AizenDove/scentOSC/README.md

<div align="center">

scentOSC logo

# scentOSC

**Scent in VRChat.** Build KVX, a 73 g scent emitter that clips onto your VR headset, and trigger it from your avatar through OSC.










[Overview](#overview) ·
[Bill of materials](#bill-of-materials) ·
[Print](#3d-printed-parts) ·
[Wiring](#wiring) ·
[Assembly](#assembly-steps) ·
[Firmware](#flashing-firmware-and-connecting-to-vrchat) ·
[Troubleshooting](#testing-and-troubleshooting) ·
[License](#license)

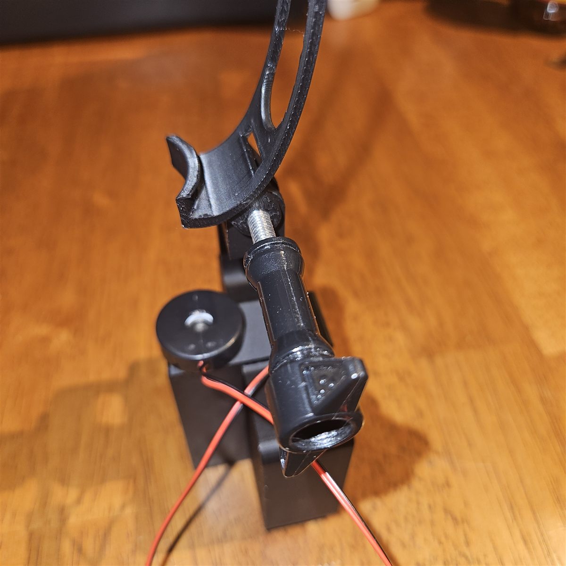
[picture p1: assets/photos/20261010_195304.jpg]
KVX mounted on a headset


</div>

> [!WARNING]
> **Work in progress:** KVX and this guide are still being developed. Parts, steps and files may change.

## Disclaimer

Build and use KVX at your own risk. I take no responsibility for injury, illness or damage.

- **Health:** breathing in scented mist may be unhealthy. If you feel unwell, take the headset off, and see a doctor if it doesn't pass.
- **Water and electronics:** the unit puts liquid next to live electronics. I take no responsibility for broken electrical components or water damage.
- **Not leak-proof:** don't lean too far forward or lie down while wearing it.
- **Run time:** the reservoir holds about 7 ml, roughly 2–3 minutes of continuous mist.
- **Spares:** keep spare transducers, as the piezo discs break easily. The wick is a consumable: replace it every time you refill. Spare 20 mm piezo discs and 10 mm wicks are sold cheaply in USB mist maker kits; see [3D printed parts](#3d-printed-parts).

## Overview

KVX is a 73 g scent emitter that mounts on your VR headset: a WEMOS LOLIN S3 drives one Grove ultrasonic atomizer, and VRChat triggers it through [ToolKitOSC](https://github.com/NekoTiki/ToolKitOSC).

```mermaid
flowchart LR
    VRC["VRChat"] -- "OSC" --> TK["ToolKitOSC<br/>desktop app"]
    TK -- "WebSocket over Wi-Fi" --> MCU["ESP32-S3"]
    MCU -- "GPIO" --> ATM["Atomizer"]
```

| | |
| --- | --- |
| **Weight** | 73 g |
| **Capsules** | 1 |
| **Power** | 5 V over USB-C, from the headset |
| **Parts** | All printable on a desktop 3D printer |
| **Headset mounts** | Meta Quest 3, Pico 4, Steam Frame, or any headset with a GoPro-style mount |

## Repository layout

```text
scentOSC/
├── README.md              this guide
├── LICENSE                CERN-OHL-S v2
├── assets/
│   ├── logo.svg
│   └── photos/            assembly photos
└── print-files/
    ├── Box.stl            electronics box with arm
    ├── Cap.stl            lid
    ├── Container-13.5mm.stl  reservoir tower with a 13.5 mm hole for the atomizer holder
    ├── step-files/        STEP versions of the KVX parts, for editing
    └── mounts/            third-party headset mounts
        ├── quest-3/
        ├── pico-4/
        └── steam-frame/
```

## Bill of materials

One KVX needs one ESP32 board, one atomizer kit and a USB-C cable to your headset. The atomizer draws at most 2 W, about 0.4 A at 5 V, so the headset's USB-C port can power the whole unit.

| Part | Qty | Key specs | Price (USD) | Where |
| --- | --- | --- | --- | --- |
| [WEMOS LOLIN S3](https://www.wemos.cc/en/latest/s3/s3.html) | 1 | ESP32-S3-WROOM-1, 3.3 V logic, 16 MB flash, 8 MB PSRAM, 65.3 × 25.4 mm, 9 g | about 7 | [AliExpress (official WEMOS store)](https://www.aliexpress.com/item/1005004643475363.html) |
| [Grove – Water Atomization v1.0](https://wiki.seeedstudio.com/Grove-Water_Atomization/) (SKU 101020090) | 1 | 5 V DC, 2 W max, 105 kHz; kit = driver board, Grove cable, ultrasonic transducer | 10.90 | [Seeed Studio](https://www.seeedstudio.com/Grove-Water-Atomization-v1-0.html) |
| Atomizer holder | 1 | 3D printed holder that clamps the 20 mm transducer and holds the 10 mm wick; use with `Container-13.5mm.stl` | — | [Thingiverse](https://www.thingiverse.com/thing:6420549) (print it yourself) |
| Jumper wires | 3 | Driver J1 pins (EN, VCC, GND) to the LOLIN S3 | — | Any electronics shop |
| USB-C cable | 1 | Headset USB-C port to the LOLIN S3; carries 5 V | — | Any |
| Wick | 1, plus plenty of spares | 10 mm cotton wick that fits the holder's tube; replace it at every refill | — | [AliExpress](https://www.aliexpress.com/item/1005005952918244.html) |
| Spare 20 mm piezo discs | Optional | Same 20 mm atomizer disc as in the Grove kit; works with the Grove driver board | — | [AliExpress](https://www.aliexpress.com/item/1005004559429683.html) |
| Scent liquid | Any | Any water-based liquid that gives off a scent; you choose what to smell. Dilute it with distilled water if it is too strong or too thick. | — | Any |
| Printed parts | 1 set | Box with arm, lid, reservoir tower, headset mount; see next section | — | Your printer |

Prices were checked on 12 Oct 2026. The LOLIN S3 price is from its launch and may have changed.

> [!NOTE]
> **Links and prices change.** The shops above are only recommendations. Look for the cheapest and most available option where you live.

## 3D printed parts

Print the three KVX parts, the atomizer holder and the mount for your headset. All files are in [`print-files/`](print-files).

| File | What it is | Supports |
| --- | --- | --- |
| [Box.stl](print-files/Box.stl) | Electronics box with the mounting arm | None |
| [Cap.stl](print-files/Cap.stl) | Lid for the box | None |
| [Container-13.5mm.stl](print-files/Container-13.5mm.stl) | Reservoir tower with a 13.5 mm hole for the atomizer holder | None |

**Atomizer holder:** print it from [4.15 Adapter for Mist Maker Kits](https://www.thingiverse.com/thing:6420549) by diy_mushroom_tek on Thingiverse (CC BY-NC-SA). Follow that page for the holder case, spare 10 mm wicks and spare 20 mm atomizers; those parts are compatible with this reservoir.

The Grove kit uses the same 20 mm piezo disc as those mist maker kits, so you still only need the Grove driver board: the wiring stays the same.

> [!WARNING]
> **Hole size must match:** the reservoir's hole diameter corresponds to the atomizer holder and wick diameter. If your holder or wick is a different size, edit the hole in the STEP file or follow the holder's guide for the best fit. Too loose and it leaks or tips; too tight and the wick gets squeezed and soaks poorly.

To modify the KVX parts in CAD, use the STEP versions in [`print-files/step-files/`](print-files/step-files).

> [!TIP]
> **Print settings:** 0.2 mm layers, 3 wall loops, 10% infill. Lay each KVX part with its largest flat face on the build plate.

**Headset mounts** are third-party designs, not made by me, and may need supports. Only the Quest 3 mount has been tested with KVX; the Pico 4 and Steam Frame mounts are untested. Any headset with a GoPro-style mount is compatible.

| Headset | File | Designer | Tested with KVX |
| --- | --- | --- | --- |
| Meta Quest 3 | [Q3_Mount.stl](print-files/mounts/quest-3/Q3_Mount.stl) | [GUUUL on Thingiverse](https://www.thingiverse.com/thing:7261225), CC BY-SA | ✅ Yes |
| Steam Frame | [sfmountv2.stl](print-files/mounts/steam-frame/sfmountv2.stl) | Third party, [Printables](https://www.printables.com/model/1868935-steam-frame-mount-for-vive-tracker-face-tracker) | ❌ No |
| Pico 4 | [HMD_Mount.stl](print-files/mounts/pico-4/HMD_Mount.stl) | Third party, [Printables](https://www.printables.com/model/495514-pico-4-babble-mouth-tracker-mount) | ❌ No |

## Tools needed

- 3D printer
- Soldering iron
- Double-sided tape, to hold the boards in the box
- USB-C data cable, for flashing the LOLIN S3
- PC with [PlatformIO](https://platformio.org/) and the ToolKitOSC desktop app
- 2.4 GHz Wi-Fi network
- Scissors, for cutting the cotton wicks
- Pipette or syringe, for filling the capsules

## Wiring

The headset powers the LOLIN S3 over USB-C, and the LOLIN S3 feeds the atomizer: EN to GPIO 4, VCC to the 5V pin, GND to GND.

```mermaid
flowchart LR
    HMD["VR headset<br/>USB-C port"] -. "5 V" .-> MCU["WEMOS LOLIN S3<br/>ESP32-S3, 3.3 V logic"]
    MCU -- "GPIO 4 → EN" --> DRV["Grove atomizer driver<br/>+ ultrasonic transducer"]
    MCU -. "5V pin → VCC" .-> DRV
    MCU -. "GND → GND" .-> DRV
```

| Driver pin (J1) | Wire in the photos | Connects to |
| --- | --- | --- |
| EN (the signal) | 🟤 Brown | GPIO 4 on the LOLIN S3 |
| VCC | 🔴 Red | 5V pin on the LOLIN S3 |
| GND | ⚫ Black | GND on the LOLIN S3 |
| NC | — | Nothing |

Plug the headset's USB-C cable into either port on the LOLIN S3; its 5V pin then carries USB power straight through to the atomizer. One atomizer draws at most 0.4 A, well within a headset's USB-C output. Any pin the firmware offers works; GPIO 4 is a suggestion.

> [!NOTE]
> Connect the driver's VCC straight to the 5V pin on the ESP32 board.

## Assembly steps

1. Lay out the parts: the electronics box with its arm, the lid, the reservoir tower, the headset mount and thumbscrew, the LOLIN S3, the Grove driver, the transducer, the atomizer holder and a wick.

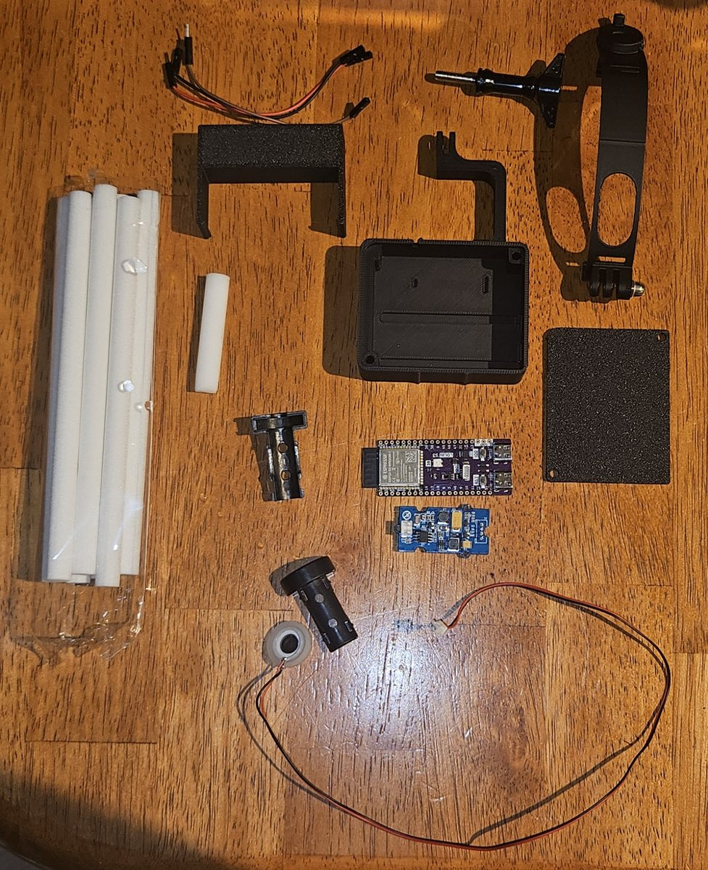
[picture p2: assets/photos/20261010_194210.jpg]
All KVX parts laid out
   

2. Seat the Grove driver in the upper bay of the box and the LOLIN S3 below it, with both USB-C ports facing the cutout in the side wall. Stick both boards down with double-sided tape so they don't shift; the next version will hold them in place.

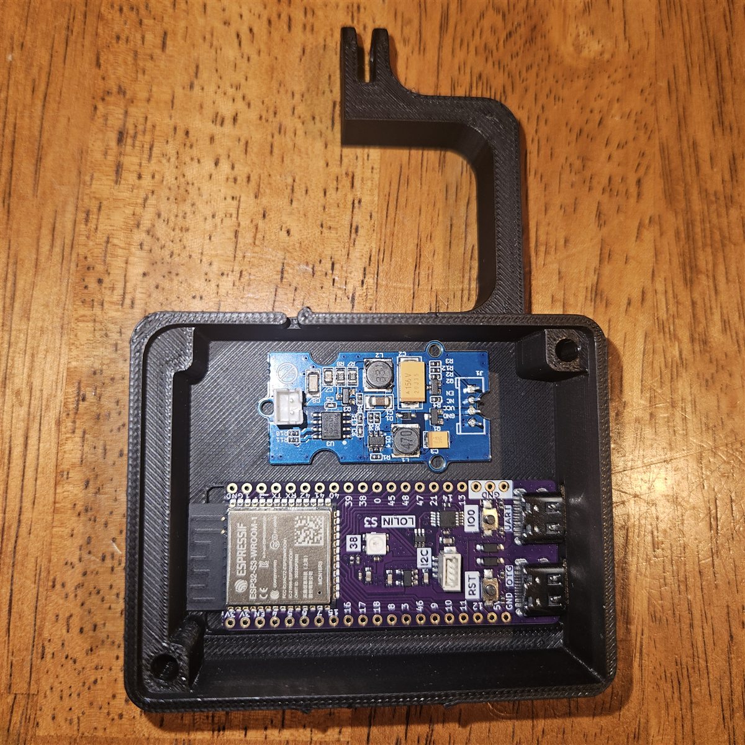
[picture p3: assets/photos/20261010_194624.jpg]
Driver and LOLIN S3 seated in the box
   

3. Run three jumper wires from the driver's J1 pins to the LOLIN S3: EN (brown) to GPIO 4, VCC (red) to 5V, GND (black) to GND.

   > [!CAUTION]
   > Never touch the transducer pins while powered: they reach 65 V. Inductor L2 on the driver board gets hot, so leave air around it.

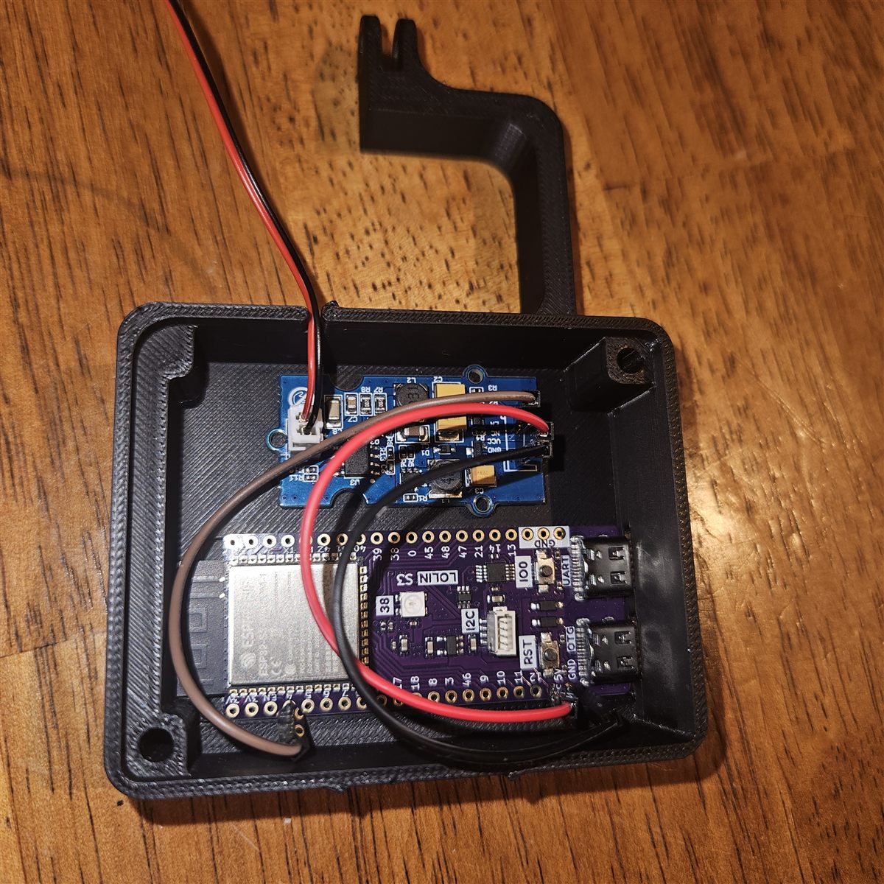
[picture p4: assets/photos/20261010_194839.jpg]
Jumper wires from the driver to GPIO 4, 5V and GND
   

4. Plug the transducer into the driver's white 2-pin socket and lead its cable out through the notch in the box wall.
5. Close the lid and fasten its two screws (optional).

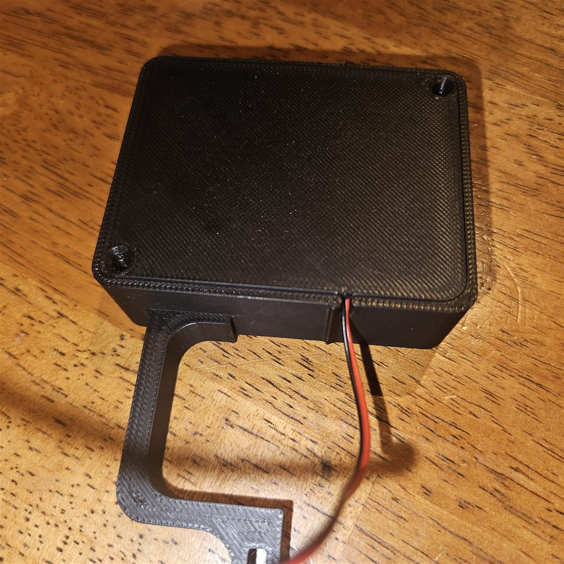
[picture p5: assets/photos/20261010_194922.jpg]
Closed box with the transducer cable leaving through the notch
   

6. Cut a fresh wick to 60 mm and push it into the atomizer holder's tube.

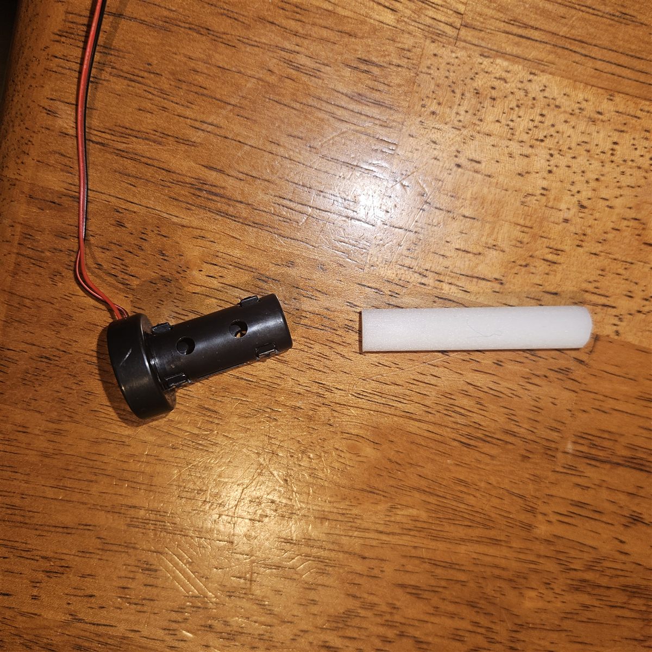
[picture p6: assets/photos/20261010_195049.jpg]
Atomizer holder and wick
   

7. Seat the transducer in the printed holder, mist side facing out.
8. Fill the reservoir tower (about 7 ml) with your water-based scent mix, then lower the holder in carefully and let the wick absorb the liquid.
   - A mix that is too thick clogs the wick and weakens the mist; dilute it with distilled water.
   - A wick that is not fully soaked gives only short bursts.

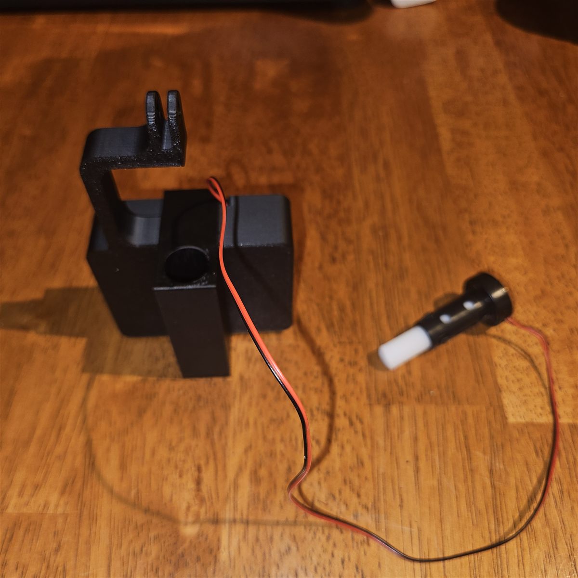
[picture p7: assets/photos/20261010_195142.jpg]
Holder ready to drop into the reservoir tower
   
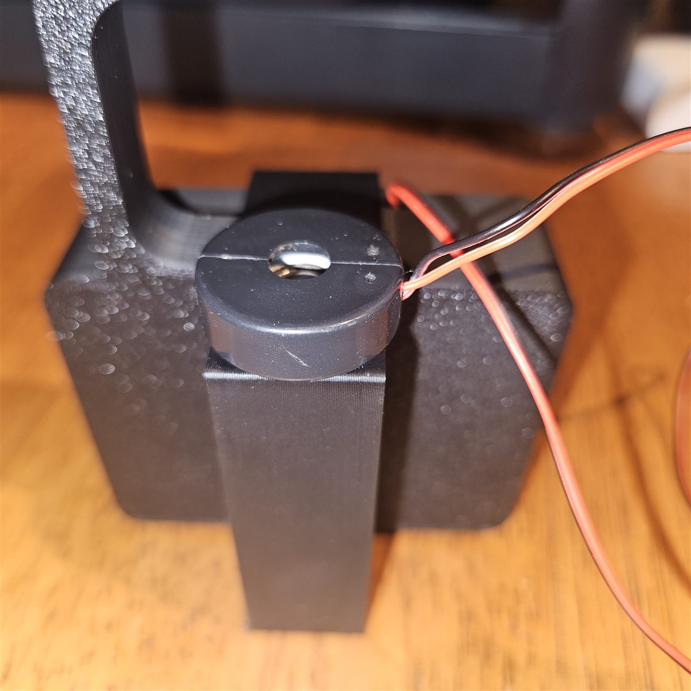
[picture p8: assets/photos/20261010_195219.jpg]
Holder seated in the tower
   

9. Attach the unit to the headset mount with the thumbscrew, plug the USB-C cable into the headset, and angle the cap so the mist lands just below your nose, not into it.

   Unit on the headset mount

## Flashing firmware and connecting to VRChat

Flash [ToolKitOSC-ESP32](https://github.com/NekoTiki/ToolKitOSC-ESP32) with the `lolin_s3` environment, then pair the board in the ToolKitOSC app.

1. Plug the LOLIN S3 into your PC through the port marked **USB**.
2. Clone the firmware and flash it:

   ```bash
   git clone https://github.com/NekoTiki/ToolKitOSC-ESP32.git
   cd ToolKitOSC-ESP32
   pio run -e lolin_s3 -t upload
   pio device monitor
   ```

3. If the upload does not connect, hold **BOOT**, tap **RST**, release BOOT and try again.
4. On first boot the board opens a Wi-Fi network called `ToolKitOSC-Setup-<id>`. Join it from your phone, pick your 2.4 GHz network, name the board, and choose the **WEMOS LOLIN S3** profile.
5. In ToolKitOSC, open **Settings › ESP32 boards**, click **Add** next to the board, then press its **BOOT** button within 30 seconds. The status LED turns green when connected.
6. Add one output on GPIO 4. Leave **active low** off: the Grove driver atomizes when its signal is HIGH.
7. Map the output to an avatar parameter. Use a pulse for short bursts (a gunshot) or PWM for intensity (a bowstring drawn further).
8. Keep **max on-time** at its 10 s default or lower, so a stuck parameter cannot run a capsule dry.

> [!IMPORTANT]
> The board switches the atomizer off if ToolKitOSC goes quiet for 3 s or Wi-Fi drops. The `TKOSC/Panic` avatar parameter stops everything at once.

## Testing and troubleshooting

Test the atomizer from the ToolKitOSC app before wearing the unit. The serial monitor shows each command as `[cmd]` and each real pin change as `[out]`.

| Symptom | Likely cause | Fix |
| --- | --- | --- |
| No mist, `[out]` shows the pin on | Wick dry or liquid too low | Refill until the wick is fully soaked |
| No mist, no `[out]` line | Output not mapped, or tripped by max on-time | Check the mapping; send off or Stop to clear the trip |
| Mist starts strong, then fades | Mix too thick, clogging the wick | Replace the wick; dilute the mix with distilled water |
| Transducer stops when wet on top | Transducer sits below the waterline | Raise it so only the hollow underside touches the wick |
| Board missing in ToolKitOSC | mDNS blocked (VPN, guest network) | Use **Add by address** with the IP from the serial monitor |
| Status LED blinks yellow | Board is not on Wi-Fi | Check that the network is 2.4 GHz; after 3 min the setup network reopens |
| Scent feels too strong | Capsule too close to the nose | Angle it lower; aim just below the nose, not into it |

To unpair, hold BOOT for 3 s while the board runs. To factory reset, hold it for 10 s.

## Sources

- Widerberg, Hong, de Petris, Fiedler, Khatibi: [Immersive Enhancement of Game Experience by Smell Sensing](https://doi.org/10.1007/978-3-032-11043-5_27), GALA 2025, LNCS 16307, pp. 280–289
- [ToolKitOSC](https://github.com/NekoTiki/ToolKitOSC), desktop app and VRChat OSC bridge
- [ToolKitOSC-ESP32](https://github.com/NekoTiki/ToolKitOSC-ESP32), board firmware
- [Grove – Water Atomization wiki](https://wiki.seeedstudio.com/Grove-Water_Atomization/), Seeed Studio
- [LOLIN S3 documentation](https://www.wemos.cc/en/latest/s3/s3.html), WEMOS
- [Quest 3 facial tracker mount](https://www.thingiverse.com/thing:7261225) by GUUUL, Thingiverse

## License

Copyright Chelsea Hong 2026.

KVX is open hardware, licensed under the [CERN Open Hardware Licence Version 2 – Strongly Reciprocal](LICENSE) (CERN-OHL-S v2). This covers the KVX print files (`Box.stl`, `Cap.stl`, `Container-13.5mm.stl`) and their STEP versions, this guide, the logo and the photos in `assets/`.

You may use, modify and share the design, and build and sell products from it. If you share a modified version, or products made from one, you must also share your modified source under the same licence.

Source location: https://github.com/AizenDove/scentOSC. As the licence requires, products made from this source must point to this location.

This source is distributed WITHOUT ANY EXPRESS OR IMPLIED WARRANTY, INCLUDING OF MERCHANTABILITY, SATISFACTORY QUALITY AND FITNESS FOR A PARTICULAR PURPOSE. Please see the CERN-OHL-S v2 for applicable conditions.

**Third-party files are not covered.** The printed atomizer holder on Thingiverse keeps its designer's CC BY-NC-SA licence. The headset mounts in [`print-files/mounts/`](print-files/mounts) keep their designers' licenses; the Quest 3 mount by GUUUL is CC BY-SA.

<div align="center">
<sub>Guide by <a href="https://github.com/AizenDove">@AizenDove</a> · last updated 23 Oct 2026</sub>
</div>
