AizenDove/scentOSC/downloads/HMD Mounts/Steam Frame/README.txt

Third-party design, not made by me. Untested with KVX.
Source: https://www.printables.com/model/1868935-steam-frame-mount-for-vive-tracker-face-tracker
