AizenDove/scentOSC/photos/originals/20261010_194210.jpg

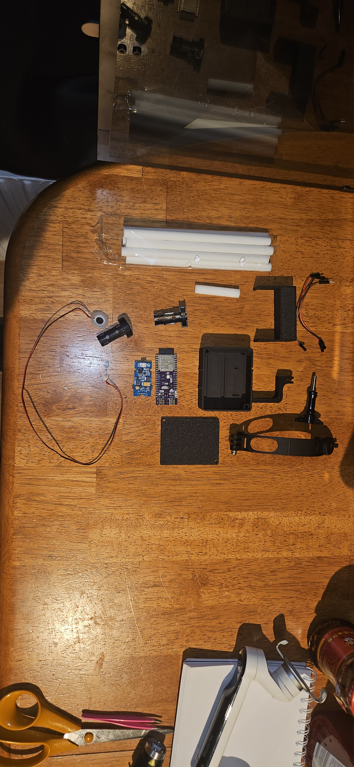
photos/originals/20261010_194210.jpg
