AizenDove/scentOSC/photos/originals/20261010_194446.jpg

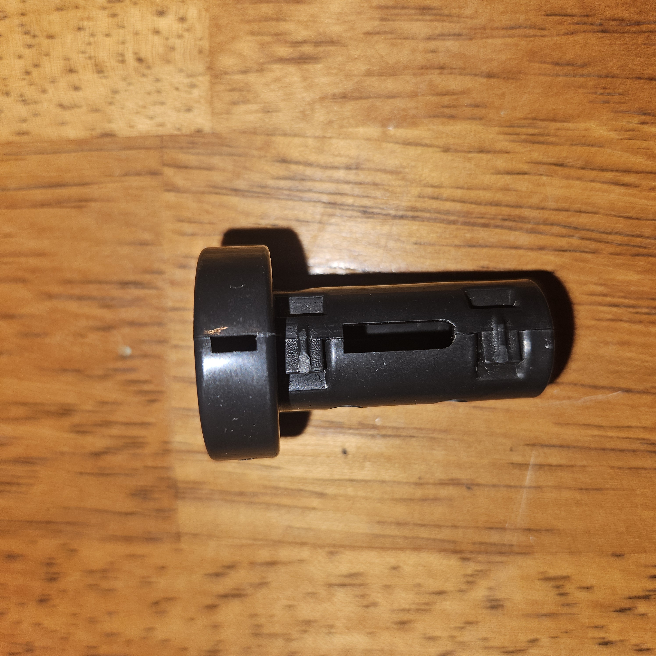
photos/originals/20261010_194446.jpg
