AizenDove/scentOSC/photos/originals/20261010_194817.jpg

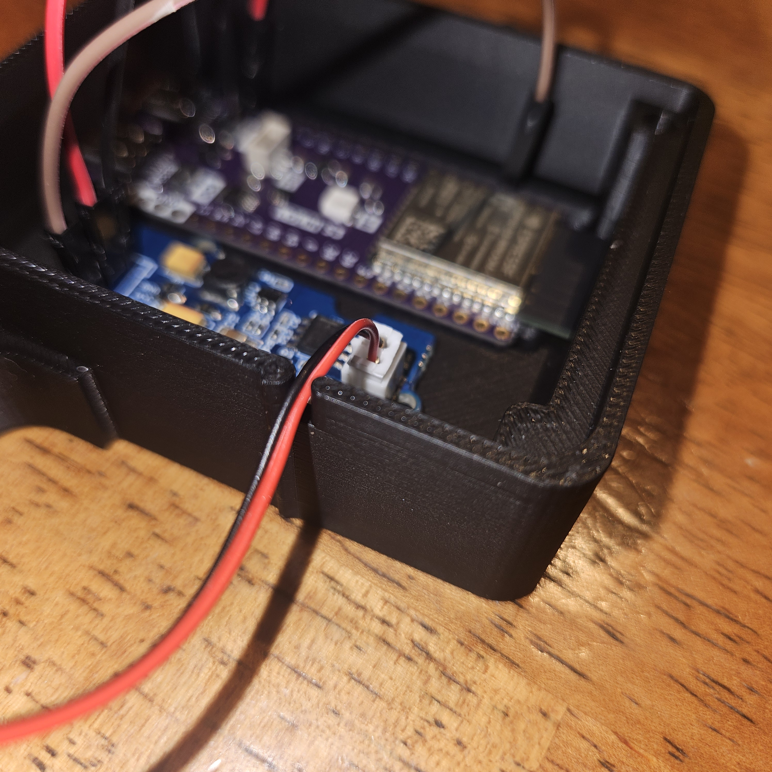
photos/originals/20261010_194817.jpg
