AizenDove/scentOSC/photos/originals/20261010_194934.jpg

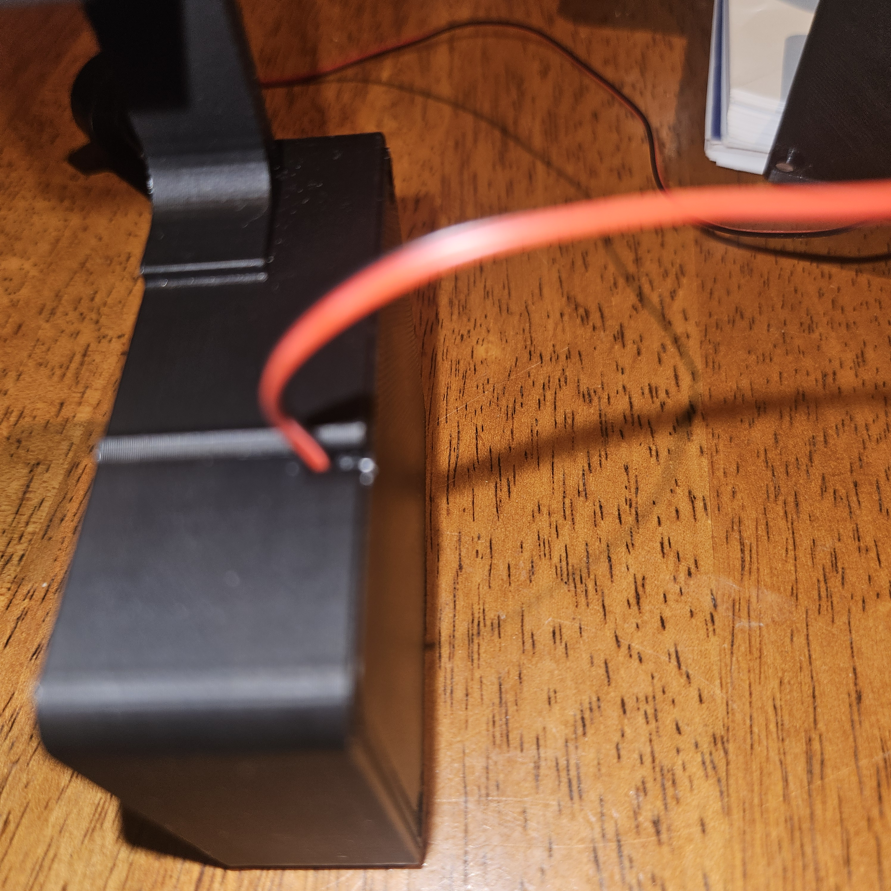
photos/originals/20261010_194934.jpg
