AizenDove/scentOSC/photos/originals/20261010_194937.jpg

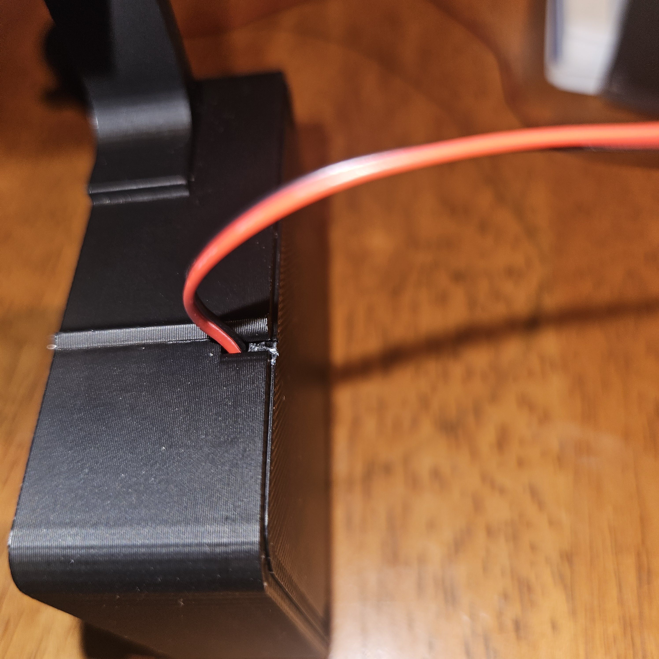
photos/originals/20261010_194937.jpg
