AizenDove/scentOSC/photos/originals/20261010_194957.jpg

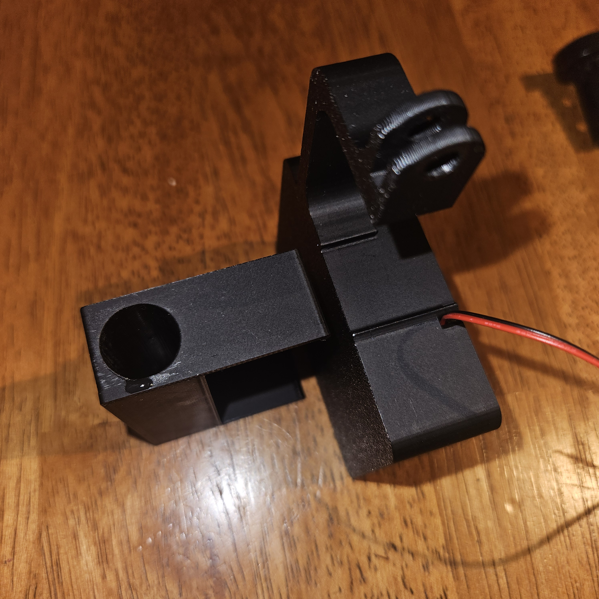
photos/originals/20261010_194957.jpg
