AizenDove/scentOSC/photos/originals/20261010_195202.jpg

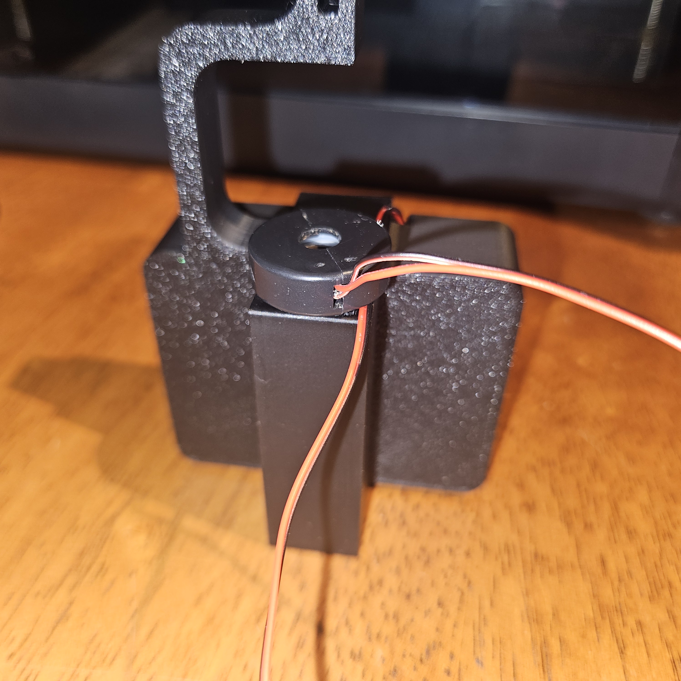
photos/originals/20261010_195202.jpg
