AizenDove/scentOSC/print-files/Cap.stl

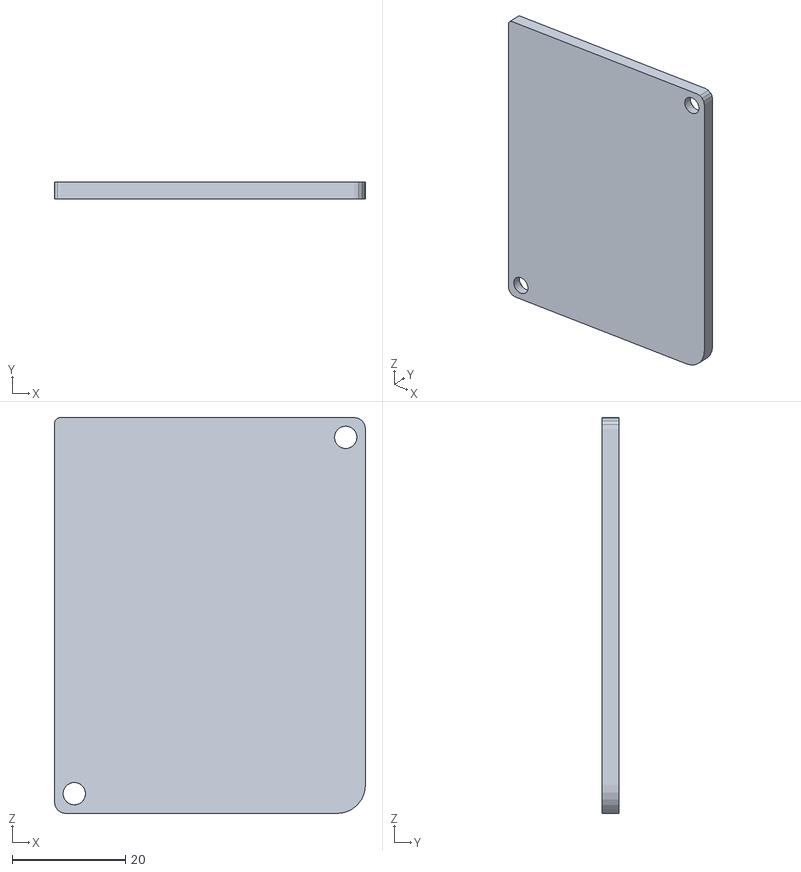
[picture p22: CAD file, 2026-10-12]
print-files/Cap.stl
54.9 x 3.00 x 69.9
