AizenDove/scentOSC/print-files/mounts/pico-4/HMD_Mount.stl

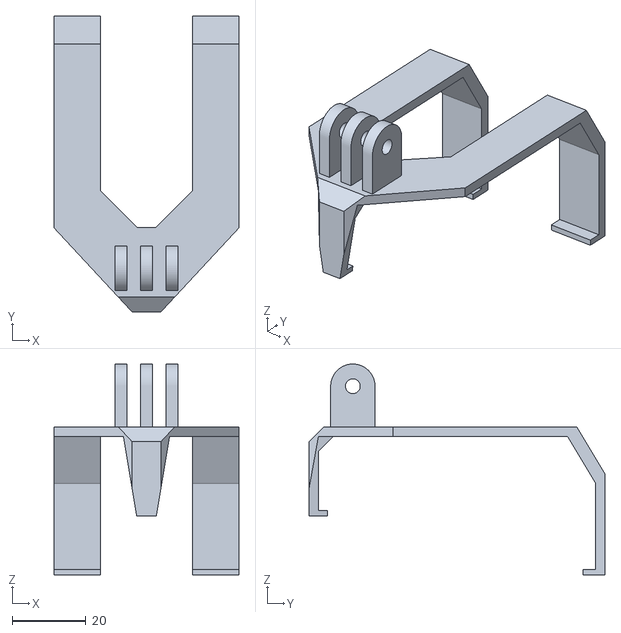
[picture p23: CAD file, 2026-10-12]
print-files/mounts/pico-4/HMD_Mount.stl
50.0 x 80.0 x 57.0
