AizenDove/scentOSC/print-files/mounts/quest-3/Q3_Mount.stl

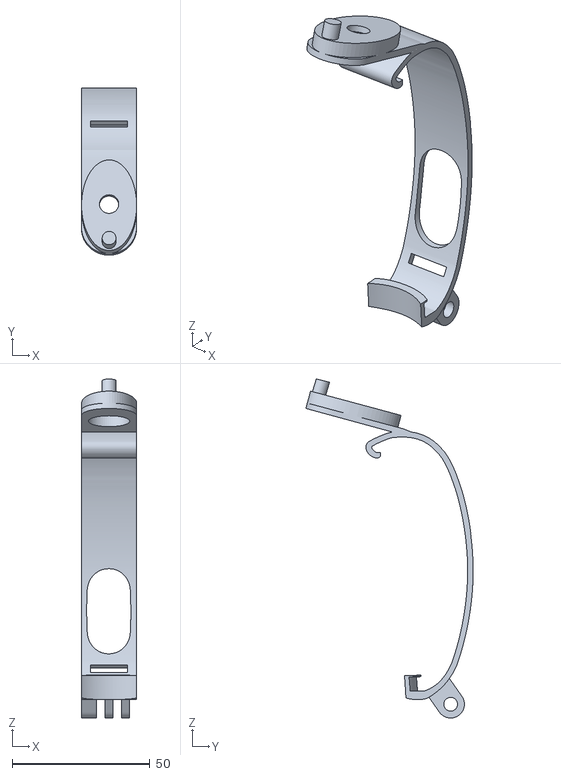
[picture p24: CAD file, 2026-10-12]
print-files/mounts/quest-3/Q3_Mount.stl
20.0 x 60.7 x 123.0
