AizenDove/scentOSC/print-files/mounts/steam-frame/sfmountv2.stl

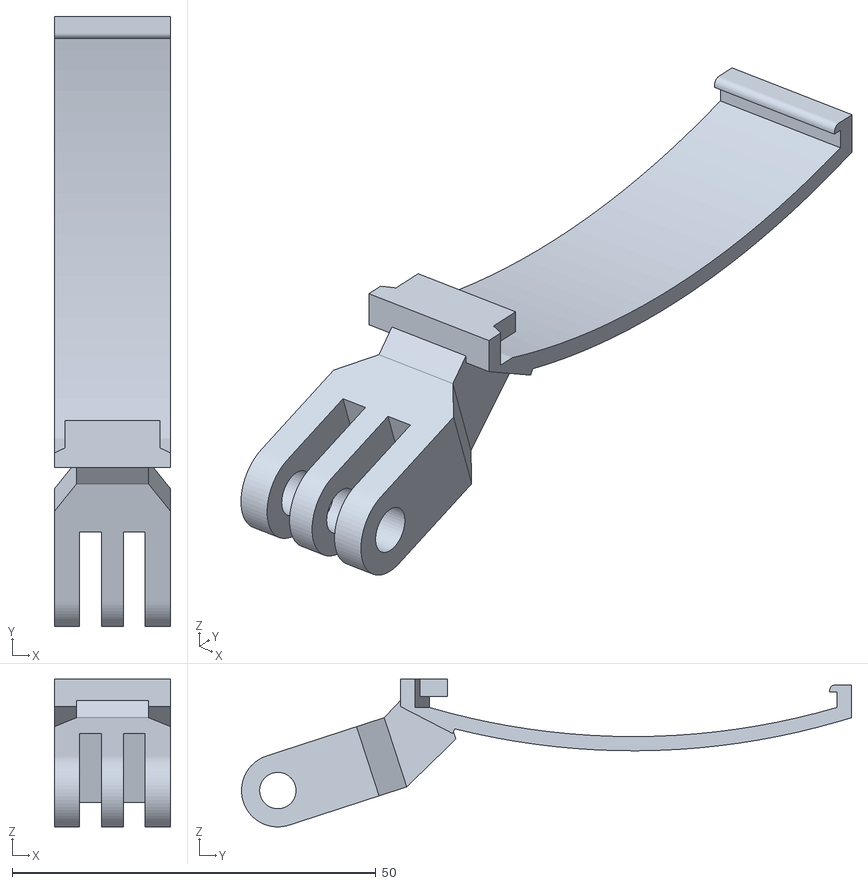
[picture p25: CAD file, 2026-10-12]
print-files/mounts/steam-frame/sfmountv2.stl
16.0 x 83.8 x 20.3
