AizenDove/scentOSC/print-files/step-files/Container-13.5mm.step

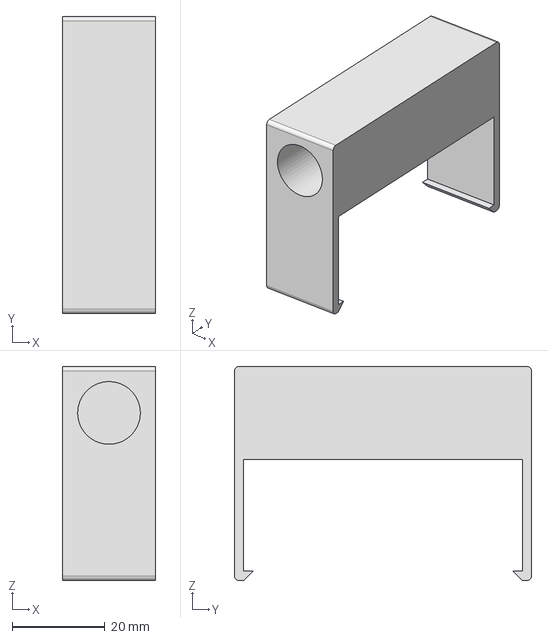
[picture p26: CAD file, 2026-10-23]
print-files/step-files/Container-13.5mm.step
20.0 x 64.0 x 46.1 mm
