AizenDove/scentOSC/print-files/Box.stl

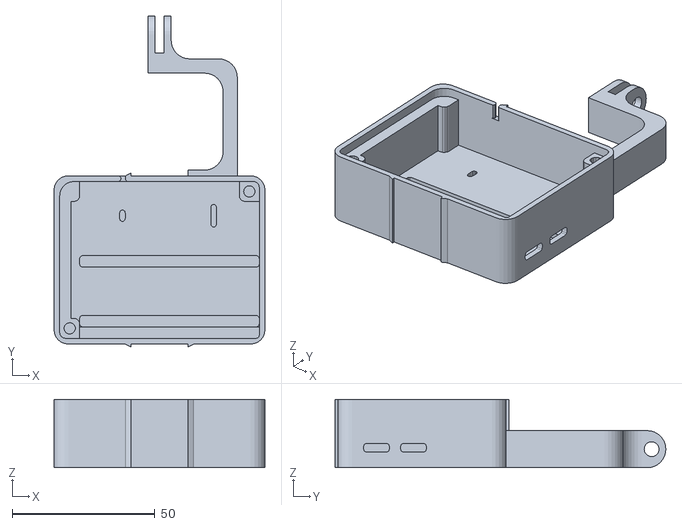
[picture p27: CAD file, 2026-10-12]
print-files/Box.stl
74.0 x 116.0 x 24.0
