AizenDove/scentOSC/(list of files, cad)

Other CAD files:
print-files/Container-13.5mm.stl
