AizenDove/scentOSC/print-files/mounts/quest-3/README.txt

facial tracker and tracker mount for Quest 3 by GUUUL on Thingiverse: https://www.thingiverse.com/thing:7261225

Summary:
Its just the V2 with the tracker mounting
