AizenDove/scentOSC/print-files/mounts/quest-3/Q3_Mount.png

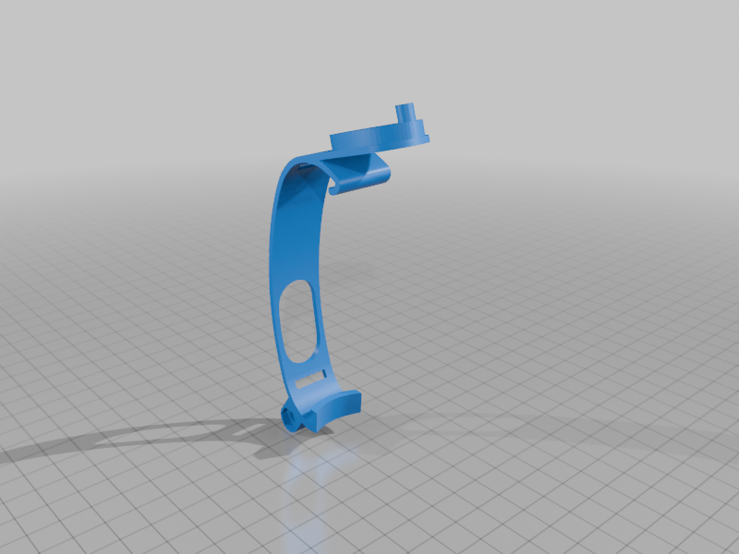
print-files/mounts/quest-3/Q3_Mount.png
