AizenDove/scentOSC/(commit log)

2026-10-12 Add hardware assembly guide
2026-10-12 Update guide for KVX: single atomizer, USB-C power, photos, disclaimer
2026-10-12 Add print files and settings; crop and rotate assembly photos
    [Box.stl, Cap.stl, Container.stl, Q3_Mount.stl, bambu lab q3 complete.3mf]
2026-10-12 Add Pico 4 and Steam Frame mounts, marked third-party and untested
    [HMD_Mount.STL, sfmountv2.stl]
2026-10-12 Add soldering iron to tools
2026-10-12 Tape boards in place until the next box revision
2026-10-12 Restructure repo and move the assembly guide into the README
    - Move the hardware assembly guide into README.md with a logo, badges,
    a quick nav and GitHub callouts
    - Rename downloads/ to print-files/ with space-free paths and flatten
    the headset mounts into mounts/<headset>/
    - Drop the Quest 3 Thingiverse zip; its extracted files are kept
    - Move photos/web/ to assets/photos/
    - Add .gitattributes, strip BOMs from text files
    [Box.stl, Cap.stl, Container.stl, HMD_Mount.stl, Q3_Mount.stl, bambu-lab-quest-3-complete.3mf, sfmountv2.stl]
2026-10-12 License hardware design under CERN-OHL-S v2
    Third-party headset mounts keep their original licenses.
2026-10-12 Credit Pico 4 mount source on Printables
2026-10-12 Add STEP versions of the KVX parts for editing
    [Box.step, Cap.step, Container.step]
2026-10-13 Remove Bambu Lab Quest 3 plate and rotate parts photo
    Drop bambu-lab-quest-3-complete.3mf and all README mentions of it,
    and rotate the parts-layout assembly photo upright.
    [bambu-lab-quest-3-complete.3mf]
2026-10-13 Generalize scent liquid, GoPro mount compatibility, wick and assembly tweaks
2026-10-23 Step files added
    [Box.step, Cap.step, Container.step]
2026-10-23 Make the 13.5 mm reservoir official and use the printed atomizer holder
    Replace Container.stl with Container-13.5mm.stl (STL and STEP), which fits
    the 3D printed atomizer holder from Thingiverse thing:6420549. Drop the
    AliExpress clip-on holder, add wick and spare 20 mm piezo links, and note
    that links and prices change.
    [Container-13.5mm.step, Container-13.5mm.stl, Container.step, Container.stl]
2026-10-23 Remove old Container.step from duplicate step files folder
    [Container.step]
2026-10-23 Add full-size assembly photo originals
2026-10-23 Remove duplicate step files folder
    [Box.step, Cap.step]
