AizenDove/scentOSC/photos/originals/20261010_194315.jpg

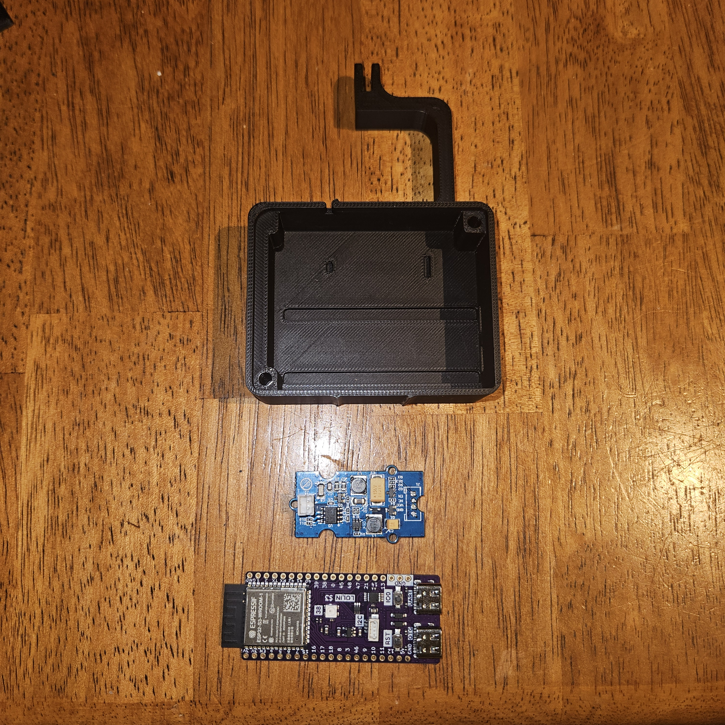
photos/originals/20261010_194315.jpg
