AizenDove/scentOSC/photos/originals/20261010_194343.jpg

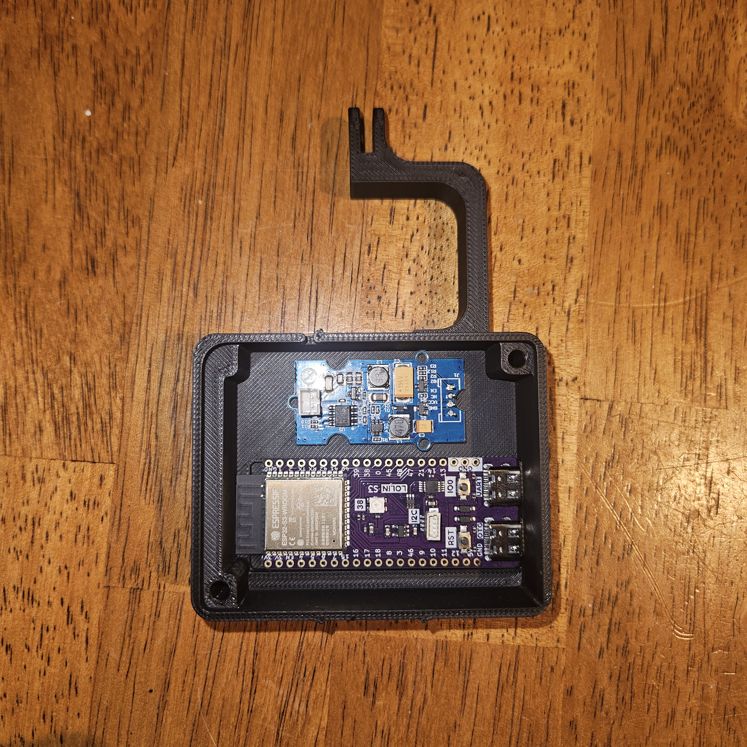
photos/originals/20261010_194343.jpg
