AizenDove/scentOSC/photos/originals/20261010_194407.jpg

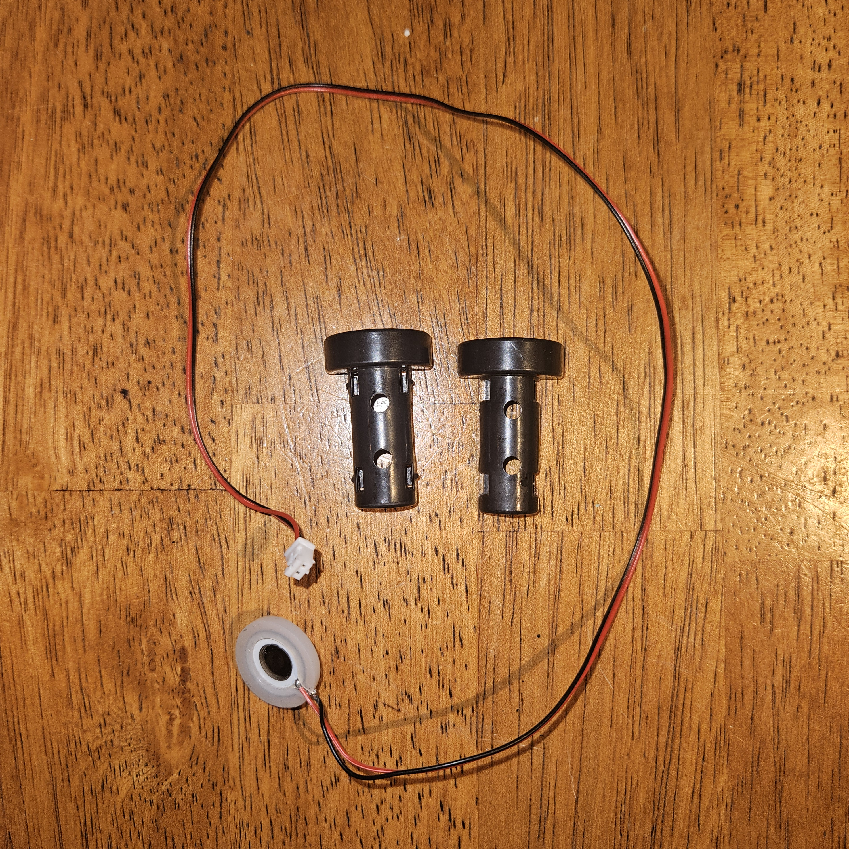
photos/originals/20261010_194407.jpg
