AizenDove/scentOSC/photos/originals/20261010_194534.jpg

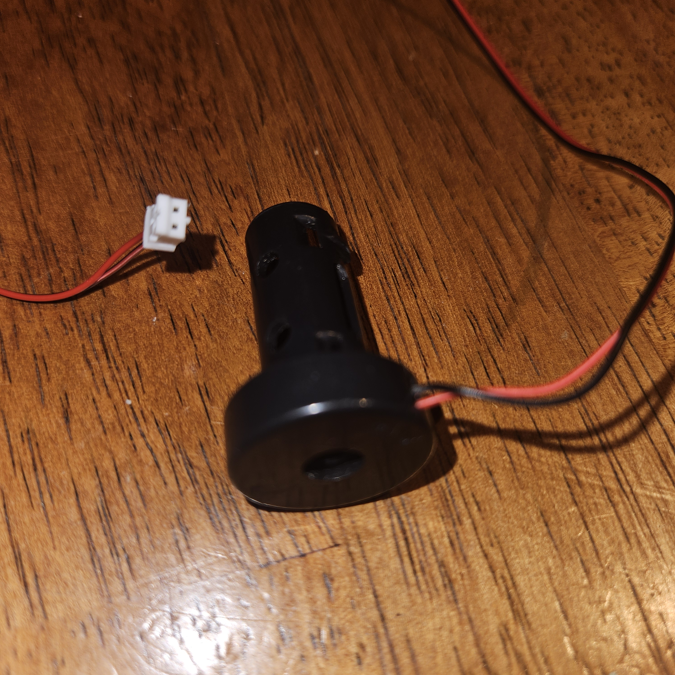
photos/originals/20261010_194534.jpg
