AizenDove/scentOSC/photos/originals/20261010_194551.jpg

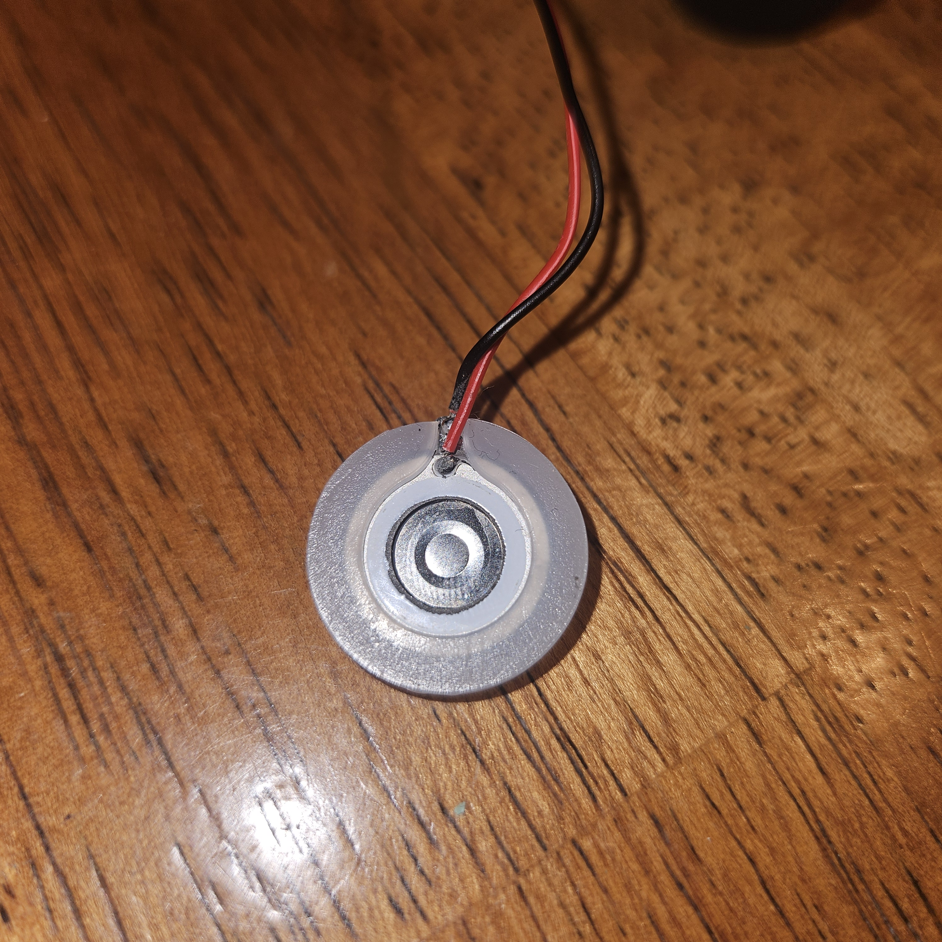
photos/originals/20261010_194551.jpg
