AizenDove/scentOSC/photos/originals/20261010_194624.jpg

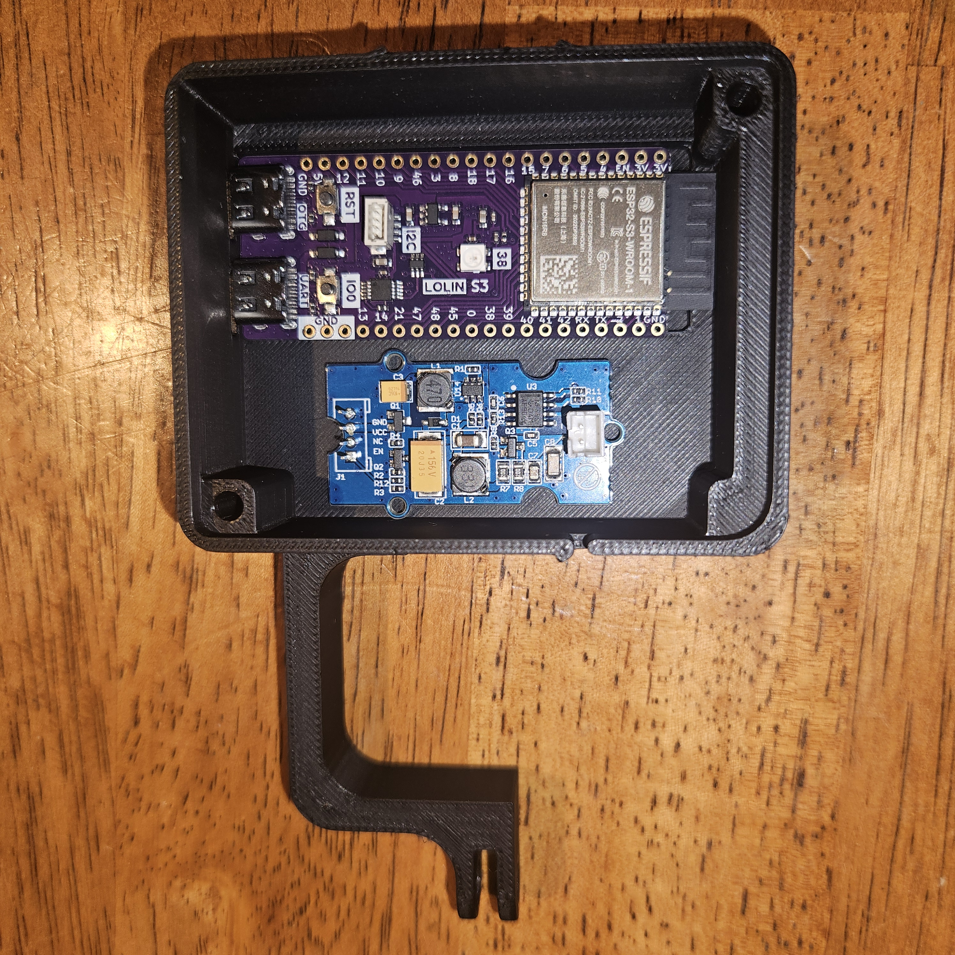
photos/originals/20261010_194624.jpg
